1801VM3/1801VM3-Board/Eagle/1203_054.brd

## EAGLE design Eagle/1203_054.brd (2017-02-23)

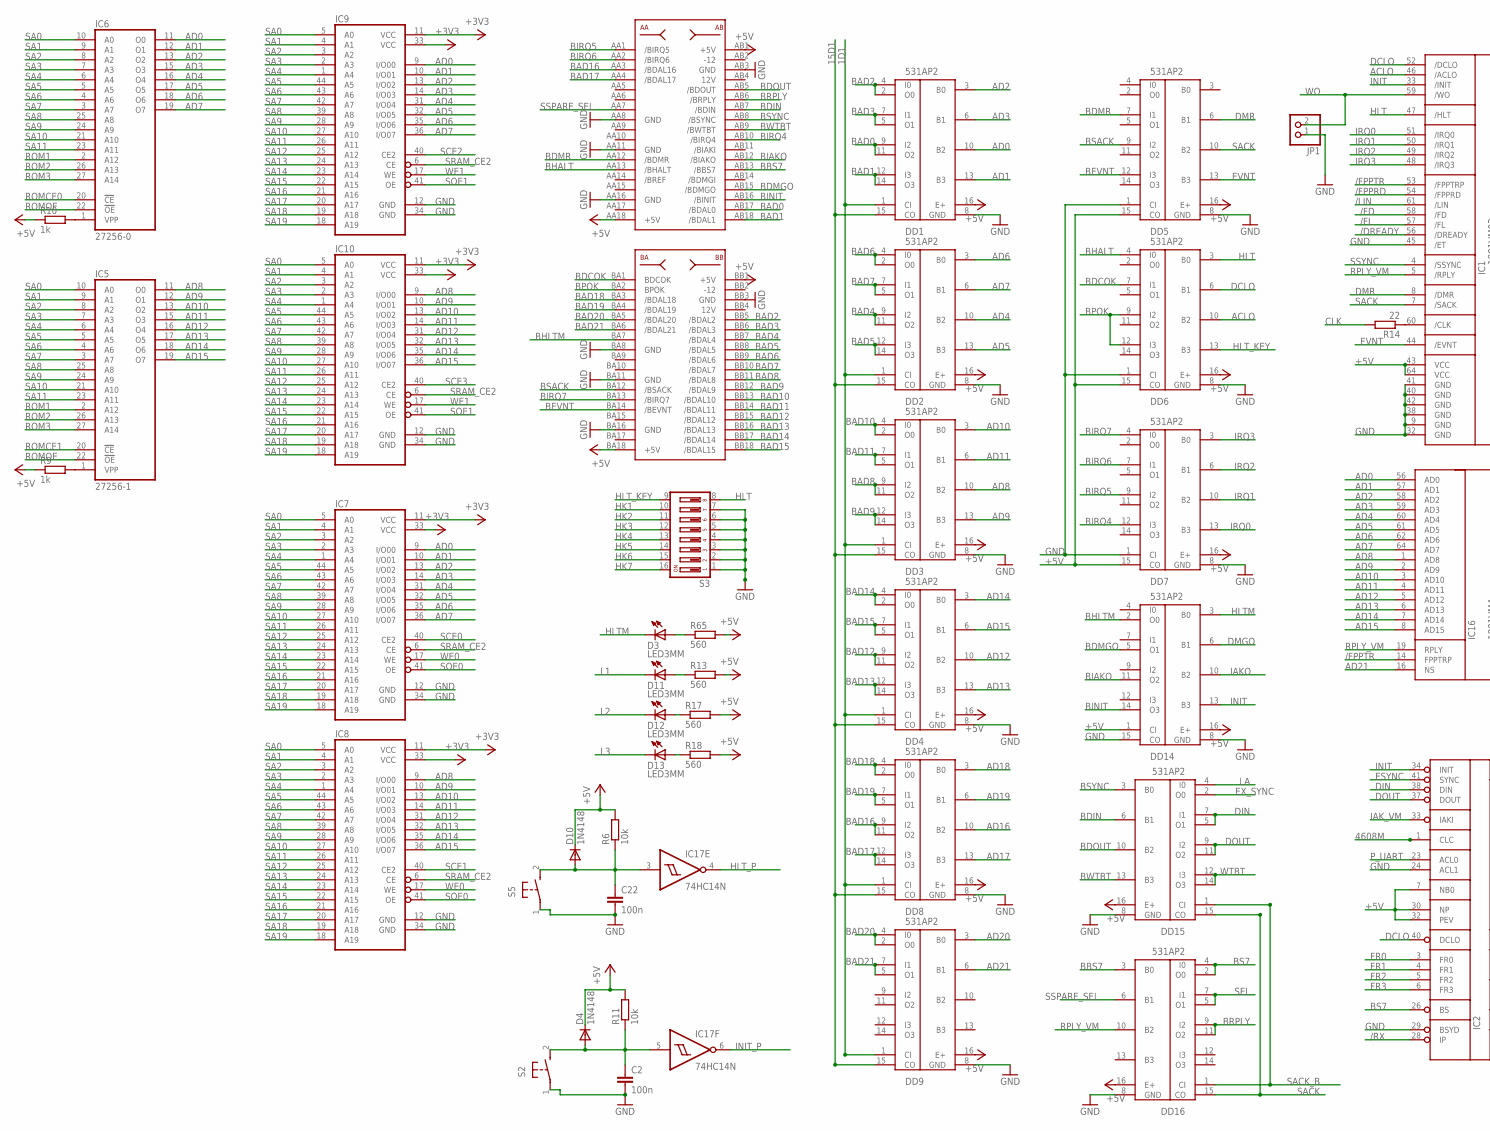
[picture p1: schematic 1203_054.sch, sheet 1, part in row 1, column 1]

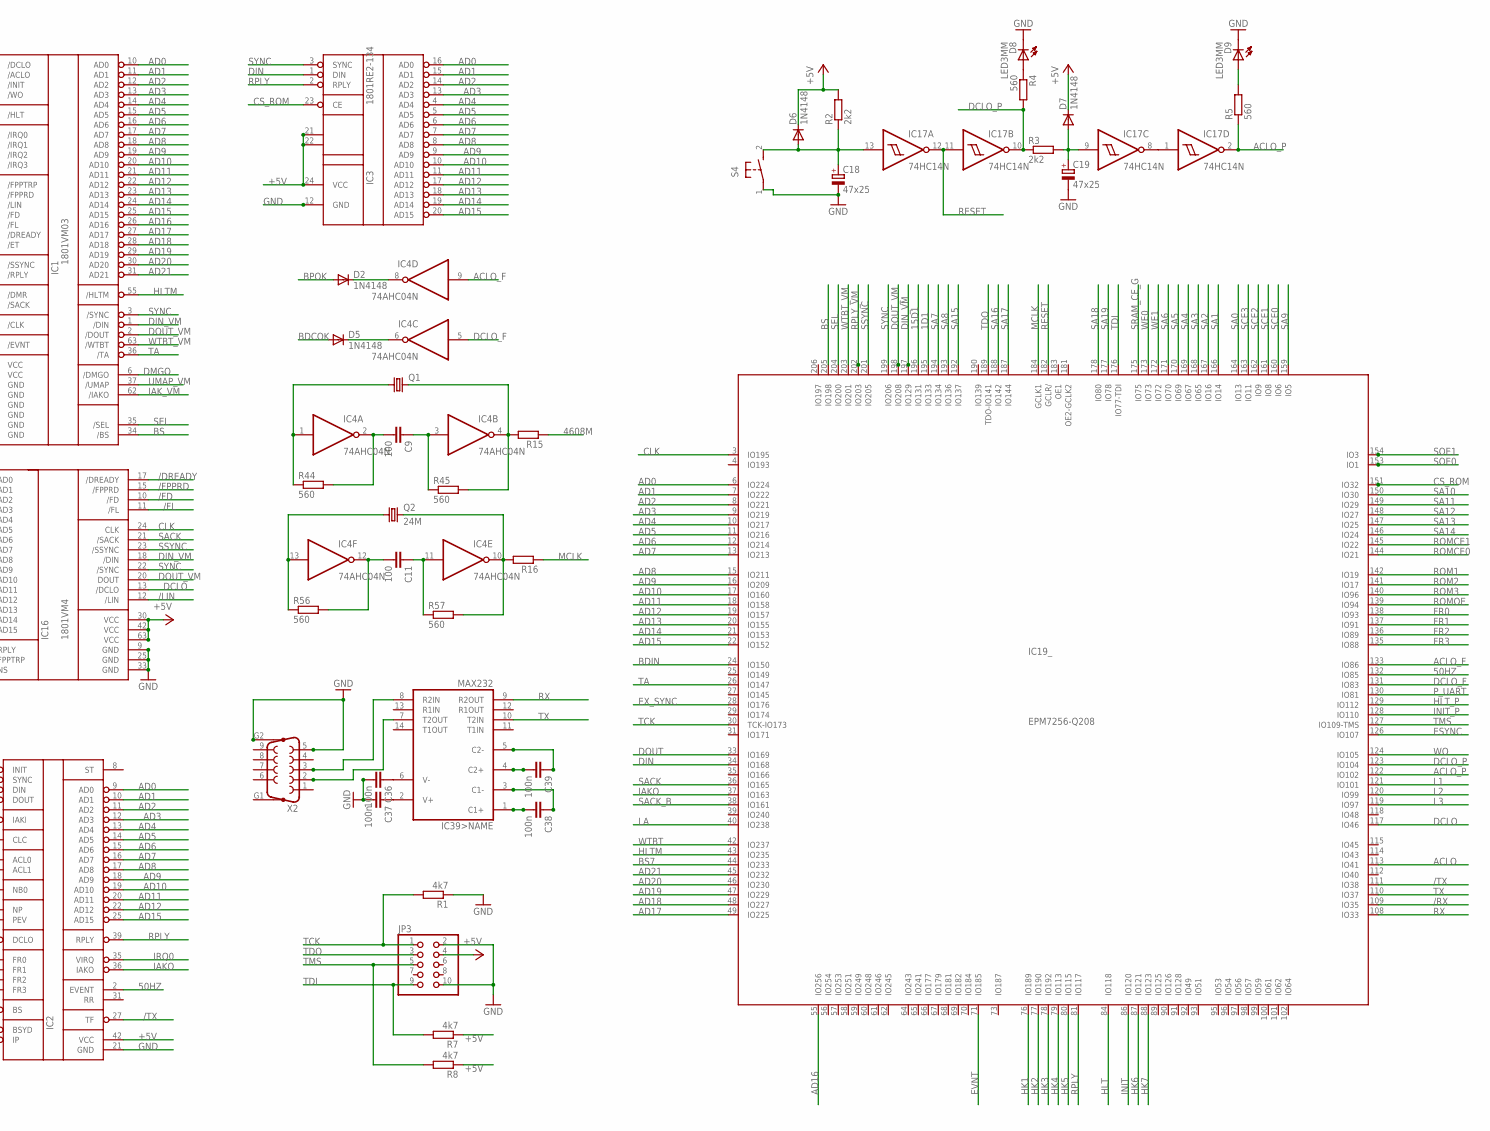
[picture p2: schematic 1203_054.sch, sheet 1, part in row 1, column 2]

Parts:
C2, C22: 100n; C050-024X044
C9, C11: 100; C025-024X044
C18, C19: 47x25; E2,5-5
C36, C37, C38, C39: 100n; C025-024X044
D2, D4, D5, D6, D7, D10: 1N4148; DO35-10
D3, D8, D9, D11, D12, D13: LED3MM
DD1, DD2, DD3, DD4, DD5, DD6, DD7, DD8, DD9, DD14, DD15, DD16: 531AP2; DIL16
IC1: 1801VM03; DIL64
IC2: 1801VP1-065; 1801
IC3: 1801RE2-134; DIL24
IC4: 74AHC04N; DIL14
IC5: 27256-1; DIL28
IC6: 27256-0; DIL28
IC7, IC8, IC9, IC10: AS6C800855Z; TSOP44
IC16: 1801VM4
IC17: 74HC14N; DIL14
IC19: EPM7256-Q208; RQFP208
IC39: MAX232; DIL16
JP1: PINHD-1X2; 1X02
JP3: PINHD-2X5; 2X05
Q1: HC49U70
Q2: 24M; HC49U70
R1, R7, R8: 4k7; M0805
R2, R3: 2k2; 0207/10
R4, R5, R13, R17, R18, R65: 560; M0805
R6, R11: 10k; 0207/10
R9, R10: 1k; M0805
R14: 22; 0204V
R15, R16: R-EU_0204/2V; 0204V
R44, R45, R56, R57: 560; 0204V
S2, S4, S5: 31-XX; B3F-31XX
S3: DP08; DP-08
X2: F09HP
XP1: CON1

Connections:
1D1: DD1.1 (CI), DD2.1 (CI), DD3.1 (CI), DD4.1 (CI), DD8.1 (CI), DD9.1 (CI), IC19.195 (IO133); also elsewhere on the board
15D1: DD1.15 (CO), DD2.15 (CO), DD3.15 (CO), DD4.15 (CO), DD8.15 (CO), DD9.15 (CO), IC19.196 (IO131)
50HZ: IC2.2 (EVENT), IC19.132 (IO85)
4608M: IC2.1 (CLC), R15.1
4608MM: IC4.10 (O), Q2.2, R16.2, R57.2
+3V3: IC7.11 (VCC), IC7.33 (VCC), IC8.11 (VCC), IC8.33 (VCC), IC9.11 (VCC), IC9.33 (VCC), IC10.11 (VCC), IC10.33 (VCC); also elsewhere on the board
+5V: D4.K (C), D6.K (C), D7.K (C), D10.K (C), DD1.16 (E+), DD2.16 (E+), DD3.16 (E+), DD4.16 (E+), DD5.15 (CO), DD5.16 (E+), DD6.15 (CO), DD6.16 (E+), DD7.15 (CO), DD7.16 (E+), DD8.16 (E+), DD9.16 (E+), DD14.1 (CI), DD14.16 (E+), DD15.16 (E+), DD16.16 (E+), IC1.43 (VCC), IC1.64 (VCC), IC2.7 (NB0), IC2.30 (NP), IC2.32 (PEV), IC2.42 (VCC), IC3.21 (F0), IC3.22 (F1), IC3.24 (VCC), IC4.14 (VCC), IC5.28 (VCC), IC6.28 (VCC), IC16.30 (VCC), IC16.42 (VCC), IC16.63 (VCC), IC17.14 (VCC), IC19.83 (VCC), IC19.179 (VCC), IC19.186 (VCC), JP3.4, R2.2, R6.2, R7.1, R8.1, R9.1, R10.1, R11.2, R13.2, R17.2, R18.2, R65.2, XP1.AA18 (+5V), XP1.AB1 (+5V), XP1.BA18 (+5V), XP1.BB1 (+5V); also elsewhere on the board
/DREADY: IC1.56 (/DREADY), IC16.17 (/DREADY); also elsewhere on the board
/FD: IC1.58 (/FD), IC16.10 (/FD); also elsewhere on the board
/FL: IC1.57 (/FL), IC16.11 (/FL); also elsewhere on the board
/FPPRD: IC1.54 (/FPPRD), IC16.15 (/FPPRD); also elsewhere on the board
/FPPTR: IC1.53 (/FPPTRP), IC16.14 (FPPTRP); also elsewhere on the board
/LIN: IC1.61 (/LIN), IC16.12 (/LIN); also elsewhere on the board
/RX: IC2.28 (IP), IC19.109 (IO35)
/TX: IC2.27 (TF), IC19.111 (IO38)
ACLO: DD6.10 (B2), IC1.46 (/ACLO), IC19.113 (IO41); also elsewhere on the board
ACLO_F: IC4.9 (I), IC19.133 (IO86)
ACLO_P: IC17.2 (O), IC19.122 (IO102), R5.1
AD0: DD1.10 (B2), IC1.10 (AD0), IC2.9 (AD0), IC3.16 (AD0), IC6.11 (O0), IC7.9 (I/O00), IC9.9 (I/O00), IC16.56 (AD0), IC19.6 (IO224); also elsewhere on the board
AD1: DD1.13 (B3), IC1.11 (AD1), IC2.10 (AD1), IC3.15 (AD1), IC6.12 (O1), IC7.10 (I/O01), IC9.10 (I/O01), IC16.57 (AD1), IC19.7 (IO222); also elsewhere on the board
AD2: DD1.3 (B0), IC1.12 (AD2), IC2.11 (AD2), IC3.14 (AD2), IC6.13 (O2), IC7.13 (I/O02), IC9.13 (I/O02), IC16.58 (AD2), IC19.8 (IO221); also elsewhere on the board
AD3: DD1.6 (B1), IC1.13 (AD3), IC2.12 (AD3), IC3.13 (AD3), IC6.15 (O3), IC7.14 (I/O03), IC9.14 (I/O03), IC16.59 (AD3), IC19.9 (IO219); also elsewhere on the board
AD4: DD2.10 (B2), IC1.14 (AD4), IC2.13 (AD4), IC3.4 (AD4), IC6.16 (O4), IC7.31 (I/O04), IC9.31 (I/O04), IC16.60 (AD4), IC19.10 (IO217); also elsewhere on the board
AD5: DD2.13 (B3), IC1.15 (AD5), IC2.14 (AD5), IC3.5 (AD5), IC6.17 (O5), IC7.32 (I/O05), IC9.32 (I/O05), IC16.61 (AD5), IC19.11 (IO216); also elsewhere on the board
AD6: DD2.3 (B0), IC1.16 (AD6), IC2.15 (AD6), IC3.6 (AD6), IC6.18 (O6), IC7.35 (I/O06), IC9.35 (I/O06), IC16.62 (AD6), IC19.12 (IO214); also elsewhere on the board
AD7: DD2.6 (B1), IC1.17 (AD7), IC2.16 (AD7), IC3.7 (AD7), IC6.19 (O7), IC7.36 (I/O07), IC9.36 (I/O07), IC16.64 (AD7), IC19.13 (IO213); also elsewhere on the board
AD8: DD3.10 (B2), IC1.18 (AD8), IC2.17 (AD8), IC3.8 (AD8), IC5.11 (O0), IC8.9 (I/O00), IC10.9 (I/O00), IC16.1 (AD8), IC19.15 (IO211); also elsewhere on the board
AD9: DD3.13 (B3), IC1.19 (AD9), IC2.18 (AD9), IC3.9 (AD9), IC5.12 (O1), IC8.10 (I/O01), IC10.10 (I/O01), IC16.2 (AD9), IC19.16 (IO209); also elsewhere on the board
AD10: DD3.3 (B0), IC1.20 (AD10), IC2.19 (AD10), IC3.10 (AD10), IC5.13 (O2), IC8.13 (I/O02), IC10.13 (I/O02), IC16.3 (AD10), IC19.17 (IO160); also elsewhere on the board
AD11: DD3.6 (B1), IC1.21 (AD11), IC2.20 (AD11), IC3.11 (AD11), IC5.15 (O3), IC8.14 (I/O03), IC10.14 (I/O03), IC16.4 (AD11), IC19.18 (IO158); also elsewhere on the board
AD12: DD4.10 (B2), IC1.22 (AD12), IC2.22 (AD12), IC3.17 (AD12), IC5.16 (O4), IC8.31 (I/O04), IC10.31 (I/O04), IC16.5 (AD12), IC19.19 (IO157); also elsewhere on the board
AD13: DD4.13 (B3), IC1.23 (AD13), IC3.18 (AD13), IC5.17 (O5), IC8.32 (I/O05), IC10.32 (I/O05), IC16.6 (AD13), IC19.20 (IO155); also elsewhere on the board
AD14: DD4.3 (B0), IC1.24 (AD14), IC3.19 (AD14), IC5.18 (O6), IC8.35 (I/O06), IC10.35 (I/O06), IC16.7 (AD14), IC19.21 (IO153); also elsewhere on the board
AD15: DD4.6 (B1), IC1.25 (AD15), IC2.25 (AD15), IC3.20 (AD15), IC5.19 (O7), IC8.36 (I/O07), IC10.36 (I/O07), IC16.8 (AD15), IC19.22 (IO152); also elsewhere on the board
AD16: DD8.10 (B2), IC1.26 (AD16), IC19.55 (IO256); also elsewhere on the board
AD17: DD8.13 (B3), IC1.27 (AD17), IC19.49 (IO225); also elsewhere on the board
AD18: DD8.3 (B0), IC1.28 (AD18), IC19.48 (IO227); also elsewhere on the board
AD19: DD8.6 (B1), IC1.29 (AD19), IC19.47 (IO229); also elsewhere on the board
AD20: DD9.3 (B0), IC1.30 (AD20), IC19.46 (IO230); also elsewhere on the board
AD21: DD9.6 (B1), IC1.31 (AD21), IC16.16 (NS), IC19.45 (IO232); also elsewhere on the board
BAD0: DD1.9 (I2), DD1.11 (O2), XP1.AB17 (/BDAL0); also elsewhere on the board
BAD1: DD1.12 (I3), DD1.14 (O3), XP1.AB18 (/BDAL1); also elsewhere on the board
BAD2: DD1.2 (O0), DD1.4 (I0), XP1.BB5 (/BDAL2); also elsewhere on the board
BAD3: DD1.5 (O1), DD1.7 (I1), XP1.BB6 (/BDAL3); also elsewhere on the board
BAD4: DD2.9 (I2), DD2.11 (O2), XP1.BB7 (/BDAL4); also elsewhere on the board
BAD5: DD2.12 (I3), DD2.14 (O3), XP1.BB8 (/BDAL5); also elsewhere on the board
BAD6: DD2.2 (O0), DD2.4 (I0), XP1.BB9 (/BDAL6); also elsewhere on the board
BAD7: DD2.5 (O1), DD2.7 (I1), XP1.BB10 (/BDAL7); also elsewhere on the board
BAD8: DD3.9 (I2), DD3.11 (O2), XP1.BB11 (/BDAL8); also elsewhere on the board
BAD9: DD3.12 (I3), DD3.14 (O3), XP1.BB12 (/BDAL9); also elsewhere on the board
BAD10: DD3.2 (O0), DD3.4 (I0), XP1.BB13 (/BDAL10); also elsewhere on the board
BAD11: DD3.5 (O1), DD3.7 (I1), XP1.BB14 (/BDAL11); also elsewhere on the board
BAD12: DD4.9 (I2), DD4.11 (O2), XP1.BB15 (/BDAL12); also elsewhere on the board
BAD13: DD4.12 (I3), DD4.14 (O3), XP1.BB16 (/BDAL13); also elsewhere on the board
BAD14: DD4.2 (O0), DD4.4 (I0), XP1.BB17 (/BDAL14); also elsewhere on the board
BAD15: DD4.5 (O1), DD4.7 (I1), XP1.BB18 (/BDAL15); also elsewhere on the board
BAD16: DD8.9 (I2), DD8.11 (O2), XP1.AA3 (/BDAL16); also elsewhere on the board
BAD17: DD8.12 (I3), DD8.14 (O3), XP1.AA4 (/BDAL17); also elsewhere on the board
BAD18: DD8.2 (O0), DD8.4 (I0), XP1.BA3 (/BDAL18); also elsewhere on the board
BAD19: DD8.5 (O1), DD8.7 (I1), XP1.BA4 (/BDAL19); also elsewhere on the board
BAD20: DD9.2 (O0), DD9.4 (I0), XP1.BA5 (/BDAL20); also elsewhere on the board
BAD21: DD9.5 (O1), DD9.7 (I1), XP1.BA6 (/BDAL21); also elsewhere on the board
BBS7: DD16.3 (B0), XP1.AB13 (/BBS7); also elsewhere on the board
BDCOK: D5.A, DD6.7 (I1), XP1.BA1 (BDCOK); also elsewhere on the board
BDIN: DD15.6 (B1), IC19.24 (IO150), XP1.AB7 (/BDIN); also elsewhere on the board
BDMGO: DD14.5 (O1), XP1.AB15 (/BDMGO); also elsewhere on the board
BDMR: DD5.7 (I1), XP1.AA12 (/BDMR); also elsewhere on the board
BDOUT: DD15.10 (B2), XP1.AB5 (/BDOUT); also elsewhere on the board
BEVNT: DD5.12 (I3), XP1.BA14 (/BEVNT); also elsewhere on the board
BHALT: DD6.4 (I0), XP1.AA13 (/BHALT); also elsewhere on the board
BHLTM: DD14.2 (O0), XP1.BA7; also elsewhere on the board
BIAKO: DD14.11 (O2), XP1.AB12 (/BIAKO); also elsewhere on the board
BINIT: DD14.14 (O3), XP1.AB16 (/BINIT); also elsewhere on the board
BIRQ4: DD7.12 (I3), XP1.AB10 (/BIRQ4); also elsewhere on the board
BIRQ5: DD7.9 (I2), XP1.AA1 (/BIRQ5); also elsewhere on the board
BIRQ6: DD7.7 (I1), XP1.AA2 (/BIRQ6); also elsewhere on the board
BIRQ7: DD7.4 (I0), XP1.BA13 (/BIRQ7); also elsewhere on the board
BPOK: D2.A, DD6.9 (I2), DD6.12 (I3), XP1.BA2 (BPOK); also elsewhere on the board
BRPLY: DD16.9 (I2), DD16.11 (O2), XP1.AB6 (/BRPLY); also elsewhere on the board
BS: IC1.34 (/BS), IC19.205 (IO198); also elsewhere on the board
BS7: DD16.2 (O0), DD16.4 (I0), IC2.26 (BS), IC19.44 (IO233); also elsewhere on the board
BSACK: DD5.9 (I2), XP1.BA12 (/BSACK); also elsewhere on the board
BSYNC: DD15.3 (B0), XP1.AB8 (/BSYNC); also elsewhere on the board
BWTBT: DD15.13 (B3), XP1.AB9 (/BWTBT); also elsewhere on the board
CLK: IC16.24 (CLK), IC19.3 (IO195), R14.2
CS_ROM: IC3.23 (CE), IC19.151 (IO32)
DCLO: DD6.6 (B1), IC1.52 (/DCLO), IC2.40 (DCLO), IC16.13 (/DCLO), IC19.117 (IO46); also elsewhere on the board
DCLO_F: IC4.5 (I), IC19.131 (IO83)
DCLO_P: IC17.10 (O), IC19.123 (IO104), R3.1, R4.2
DIN: DD15.5 (O1), DD15.7 (I1), IC2.38 (DIN), IC3.1 (DIN), IC19.34 (IO168); also elsewhere on the board
DIN_VM: IC1.1 (/DIN), IC16.18 (/DIN), IC19.197 (IO129); also elsewhere on the board
DMGO: DD14.6 (B1), IC1.6 (/DMGO); also elsewhere on the board
DMR: DD5.6 (B1), IC1.8 (/DMR); also elsewhere on the board
DOUT: DD15.9 (I2), DD15.11 (O2), IC2.37 (DOUT), IC19.33 (IO169); also elsewhere on the board
DOUT_VM: IC1.2 (/DOUT), IC16.20 (DOUT), IC19.198 (IO208); also elsewhere on the board
ESYNC: IC2.41 (SYNC), IC19.126 (IO107)
EVNT: DD5.13 (B3), IC1.44 (/EVNT), IC19.71 (IO185); also elsewhere on the board
EX_SYNC: DD15.2 (O0), IC19.28 (IO176); also elsewhere on the board
FR0: IC2.3 (FR0), IC19.138 (IO93)
FR1: IC2.4 (FR1), IC19.137 (IO91)
FR2: IC2.5 (FR2), IC19.136 (IO89)
FR3: IC2.6 (FR3), IC19.135 (IO88)
GND: C2.2, C18.-, C19.-, C22.2, C36.2, C37.2, D8.K (C), D9.K (C), DD1.8 (GND), DD2.8 (GND), DD3.8 (GND), DD4.8 (GND), DD5.1 (CI), DD5.8 (GND), DD6.1 (CI), DD6.8 (GND), DD7.1 (CI), DD7.8 (GND), DD8.8 (GND), DD9.8 (GND), DD14.8 (GND), DD14.15 (CO), DD15.8 (GND), DD16.8 (GND), IC1.9 (GND), IC1.32 (GND), IC1.38 (GND), IC1.40 (GND), IC1.41 (GND), IC1.42 (GND), IC1.45 (/ET), IC2.21 (GND), IC2.24 (ACL1), IC2.29 (BSYD), IC3.12 (GND), IC4.7 (GND), IC5.14 (GND), IC6.14 (GND), IC7.12 (GND), IC7.34 (GND), IC8.12 (GND), IC8.34 (GND), IC9.12 (GND), IC9.34 (GND), IC10.12 (GND), IC10.34 (GND), IC16.9 (GND), IC16.25 (GND), IC16.33 (GND), IC17.7 (GND), JP1.1, JP3.2, JP3.10, R1.1, S2.1, S3.1, S3.2, S3.3, S3.4, S3.5, S3.6, S3.7, S4.1, S5.1, X2.5, X2.G2, XP1.AA8 (GND), XP1.AA11 (GND), XP1.AA16 (GND), XP1.AB3 (GND), XP1.BA8 (GND), XP1.BA11 (GND), XP1.BA16 (GND), XP1.BB3 (GND); also elsewhere on the board
HK1: IC19.76 (IO189), S3.10; also elsewhere on the board
HK2: IC19.77 (IO190), S3.11; also elsewhere on the board
HK3: IC19.78 (IO192), S3.12; also elsewhere on the board
HK4: IC19.79 (IO113), S3.13; also elsewhere on the board
HK5: IC19.80 (IO115), S3.14; also elsewhere on the board
HK6: IC19.87 (IO121), S3.15; also elsewhere on the board
HK7: IC19.88 (IO123), S3.16; also elsewhere on the board
HLT: DD6.3 (B0), IC1.47 (/HLT), IC19.84 (IO118), S3.8; also elsewhere on the board
HLTM: D3.K (C), DD14.3 (B0), IC1.55 (/HLTM), IC19.43 (IO235); also elsewhere on the board
HLT_KEY: DD6.13 (B3), S3.9
HLT_P: IC17.4 (O), IC19.129 (IO112)
IAKO: DD14.10 (B2), IC2.36 (IAKO), IC19.37 (IO163)
IAK_VM: IC1.62 (/IAKO), IC2.33 (IAKI); also elsewhere on the board
INIT: DD14.13 (B3), IC1.33 (/INIT), IC2.34 (INIT), IC19.86 (IO120); also elsewhere on the board
INIT_P: IC17.6 (O), IC19.128 (IO110)
IRQ0: DD7.13 (B3), IC1.51 (/IRQ0), IC2.35 (VIRQ); also elsewhere on the board
IRQ1: DD7.10 (B2), IC1.50 (/IRQ1); also elsewhere on the board
IRQ2: DD7.6 (B1), IC1.49 (/IRQ2); also elsewhere on the board
IRQ3: DD7.3 (B0), IC1.48 (/IRQ3); also elsewhere on the board
L1: D11.K (C), IC19.121 (IO101)
L2: D12.K (C), IC19.120 (IO99)
L3: D13.K (C), IC19.119 (IO97)
LA: DD15.4 (I0), IC19.40 (IO238)
MCLK: IC19.184 (GCLK1), R16.1
MCLKK: IC4.4 (O), Q1.2, R15.2, R45.2
unnamed: IC6.1 (VPP), R10.2
unnamed: IC17.1 (I), IC17.8 (O)
unnamed: C38.1, IC39.3 (C1-)
unnamed: D9.A, R5.2
unnamed: C18.+, D6.A, IC17.13 (I), R2.1, S4.2
unnamed: IC4.1 (I), Q1.1, R44.1
unnamed: D3.A, R65.1
unnamed: C9.2, IC4.2 (O), R44.2
unnamed: C19.+, D7.A, IC17.9 (I), R3.2
unnamed: D8.A, R4.1
unnamed: IC5.1 (VPP), R9.2
unnamed: C22.1, D10.A, IC17.3 (I), R6.1, S5.2
unnamed: D11.A, R13.1
unnamed: IC1.60 (/CLK), R14.1
unnamed: D2.K (C), IC4.8 (O)
unnamed: D5.K (C), IC4.6 (O)
unnamed: C2.1, D4.A, IC17.5 (I), R11.1, S2.2
unnamed: D12.A, R17.1
unnamed: D13.A, R18.1
unnamed: IC4.13 (I), Q2.1, R56.1
unnamed: C9.1, IC4.3 (I), R45.1
unnamed: C38.2, IC39.1 (C1+)
unnamed: C39.2, IC39.4 (C2+)
unnamed: C39.1, IC39.5 (C2-)
unnamed: IC39.7 (T2OUT), X2.2
unnamed: IC39.8 (R2IN), X2.3
unnamed: C36.1, IC39.6 (V-)
unnamed: C37.1, IC39.2 (V+)
unnamed: C11.2, IC4.12 (O), R56.2
unnamed: C11.1, IC4.11 (I), R57.1
P_UART: IC2.23 (ACL0), IC19.130 (IO81)
RESET: IC17.11 (I), IC17.12 (O), IC19.182 (GCLR/)
ROM1: IC5.2 (A12), IC6.2 (A12), IC19.142 (IO19)
ROM2: IC5.26 (A13), IC6.26 (A13), IC19.141 (IO17)
ROM3: IC5.27 (A14), IC6.27 (A14), IC19.140 (IO96)
ROMCE0: IC6.20 (!CE), IC19.144 (IO21)
ROMCE1: IC5.20 (!CE), IC19.145 (IO22)
ROMOE: IC5.22 (!OE), IC6.22 (!OE), IC19.139 (IO94)
RPLY: IC2.39 (RPLY), IC3.2 (RPLY), IC19.81 (IO117); also elsewhere on the board
RPLY_VM: DD16.10 (B2), IC1.5 (/RPLY), IC16.19 (RPLY), IC19.202 (IO203); also elsewhere on the board
RX: IC19.108 (IO33), IC39.9 (R2OUT)
SA0: IC5.10 (A0), IC6.10 (A0), IC7.5 (A0), IC8.5 (A0), IC9.5 (A0), IC10.5 (A0), IC19.164 (IO13)
SA1: IC5.9 (A1), IC6.9 (A1), IC7.4 (A1), IC8.4 (A1), IC9.4 (A1), IC10.4 (A1), IC19.166 (IO14)
SA2: IC5.8 (A2), IC6.8 (A2), IC7.3 (A2), IC8.3 (A2), IC9.3 (A2), IC10.3 (A2), IC19.167 (IO16)
SA3: IC5.7 (A3), IC6.7 (A3), IC7.2 (A3), IC8.2 (A3), IC9.2 (A3), IC10.2 (A3), IC19.168 (IO65)
SA4: IC5.6 (A4), IC6.6 (A4), IC7.1 (A4), IC8.1 (A4), IC9.1 (A4), IC10.1 (A4), IC19.169 (IO67)
SA5: IC5.5 (A5), IC6.5 (A5), IC7.44 (A5), IC8.44 (A5), IC9.44 (A5), IC10.44 (A5), IC19.170 (IO69)
SA6: IC5.4 (A6), IC6.4 (A6), IC7.43 (A6), IC8.43 (A6), IC9.43 (A6), IC10.43 (A6), IC19.171 (IO70)
SA7: IC5.3 (A7), IC6.3 (A7), IC7.42 (A7), IC8.42 (A7), IC9.42 (A7), IC10.42 (A7), IC19.194 (IO134)
SA8: IC5.25 (A8), IC6.25 (A8), IC7.39 (A8), IC8.39 (A8), IC9.39 (A8), IC10.39 (A8), IC19.193 (IO136)
SA9: IC5.24 (A9), IC6.24 (A9), IC7.28 (A9), IC8.28 (A9), IC9.28 (A9), IC10.28 (A9), IC19.159 (IO5)
SA10: IC5.21 (A10), IC6.21 (A10), IC7.27 (A10), IC8.27 (A10), IC9.27 (A10), IC10.27 (A10), IC19.150 (IO30)
SA11: IC5.23 (A11), IC6.23 (A11), IC7.26 (A11), IC8.26 (A11), IC9.26 (A11), IC10.26 (A11), IC19.149 (IO29)
SA12: IC7.25 (A12), IC8.25 (A12), IC9.25 (A12), IC10.25 (A12), IC19.148 (IO27)
SA13: IC7.24 (A13), IC8.24 (A13), IC9.24 (A13), IC10.24 (A13), IC19.147 (IO25)
SA14: IC7.23 (A14), IC8.23 (A14), IC9.23 (A14), IC10.23 (A14), IC19.146 (IO24)
SA15: IC7.22 (A15), IC8.22 (A15), IC9.22 (A15), IC10.22 (A15), IC19.192 (IO137)
SA16: IC7.21 (A16), IC8.21 (A16), IC9.21 (A16), IC10.21 (A16), IC19.188 (IO142)
SA17: IC7.20 (A17), IC8.20 (A17), IC9.20 (A17), IC10.20 (A17), IC19.187 (IO144)
SA18: IC7.19 (A18), IC8.19 (A18), IC9.19 (A18), IC10.19 (A18), IC19.178 (IO80)
SA19: IC7.18 (A19), IC8.18 (A19), IC9.18 (A19), IC10.18 (A19), IC19.177 (IO78)
SACK: DD5.10 (B2), DD15.15 (CO), DD16.15 (CO), IC1.7 (/SACK), IC16.21 (/SACK), IC19.36 (IO165); also elsewhere on the board
SACK_B: DD15.1 (CI), DD16.1 (CI), IC19.38 (IO161)
SCE0: IC7.40 (CE2), IC19.160 (IO6)
SCE1: IC8.40 (CE2), IC19.161 (IO8)
SCE2: IC9.40 (CE2), IC19.162 (IO9)
SCE3: IC10.40 (CE2), IC19.163 (IO11)
SEL: DD16.5 (O1), DD16.7 (I1), IC1.35 (/SEL), IC19.204 (IO200); also elsewhere on the board
SOE0: IC7.41 (OE), IC8.41 (OE), IC19.153 (IO1)
SOE1: IC9.41 (OE), IC10.41 (OE), IC19.154 (IO3)
SRAM_CE2: IC7.6 (CE), IC8.6 (CE), IC9.6 (CE), IC10.6 (CE); also elsewhere on the board
SRAM_CE_G: IC19.175 (IO75); also elsewhere on the board
SSPARE_SEL: DD16.6 (B1), XP1.AA7; also elsewhere on the board
SSYNC: IC1.4 (/SSYNC), IC16.23 (/SSYNC), IC19.201 (IO205); also elsewhere on the board
SYNC: IC1.3 (/SYNC), IC3.3 (SYNC), IC16.22 (/SYNC), IC19.199 (IO206); also elsewhere on the board
TA: IC1.36 (/TA), IC19.26 (IO147); also elsewhere on the board
TCK: IC19.30 (TCK-IO173), JP3.1, R1.2
TDI: IC19.176 (IO77-TDI), JP3.9, R7.2
TDO: IC19.189 (TDO-IO141), JP3.3
TMS: IC19.127 (IO109-TMS), JP3.5, R8.2
TX: IC19.110 (IO37), IC39.10 (T2IN)
UMAP_VM: IC1.37 (/UMAP); also elsewhere on the board
WE0: IC7.17 (WE), IC8.17 (WE), IC19.173 (IO73)
WE1: IC9.17 (WE), IC10.17 (WE), IC19.172 (IO72)
WO: IC1.59 (/WO), IC19.124 (IO105), JP1.2; also elsewhere on the board
WTBT: DD15.12 (I3), DD15.14 (O3), IC19.42 (IO237); also elsewhere on the board
WTBT_VM: IC1.63 (/WTBT), IC19.203 (IO201); also elsewhere on the board

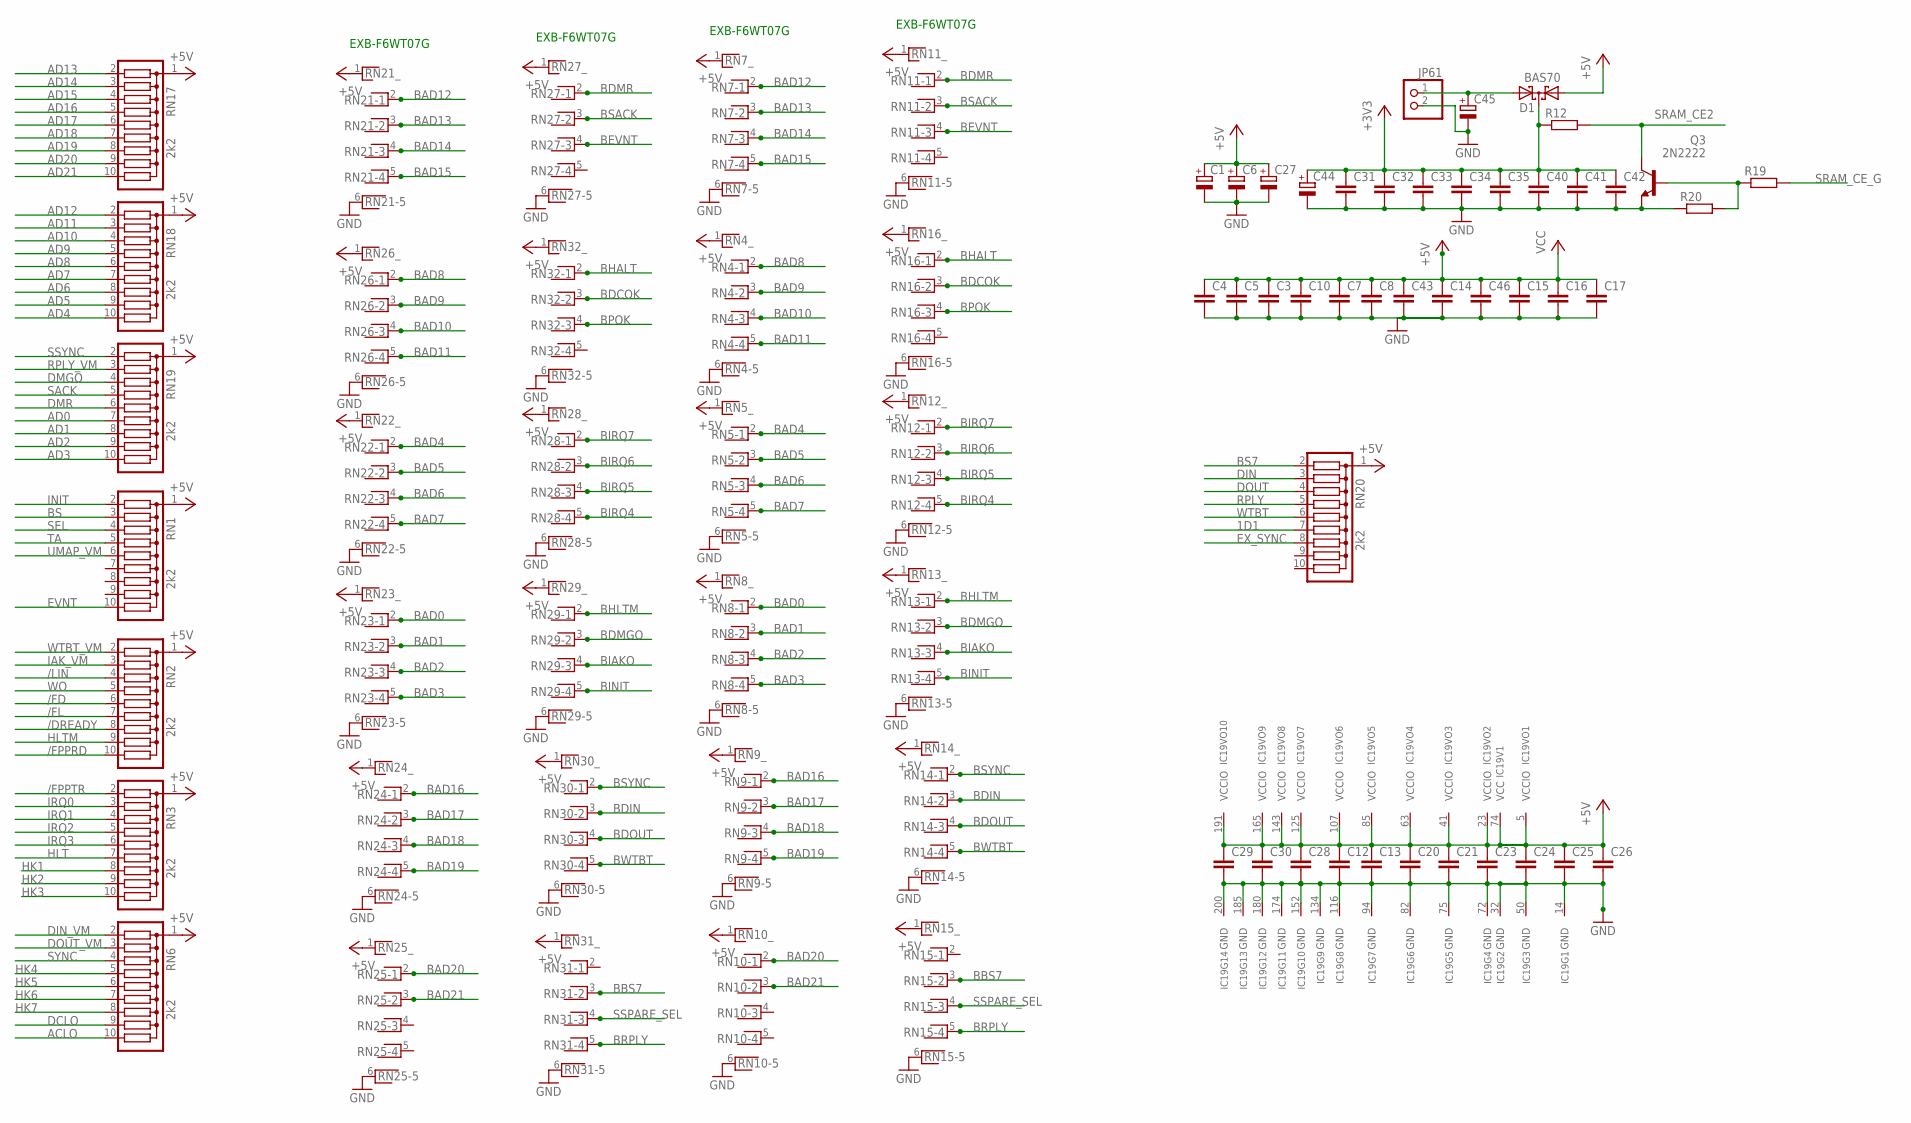
[picture p3: schematic 1203_054.sch, sheet 2]

Parts:
C1, C6, C27: CPOL-EUCT6032; CT6032
C3, C4, C5, C7, C8, C10, C14, C15, C16, C17, C23, C24, C25, C26, C28, C29, C30, C43, C46: C-EU050-024X044; C050-024X044
C12, C13, C20, C21: C-EUC0805; C0805
C31, C32, C33, C34, C35, C40, C41, C42: C-EUC0603; C0603
C44, C45: CPOL-EUCT7343; CT7343
D1: BAS70; SOT23
IC19: EPM7256-Q208; RQFP208
JP61: PINHD-1X2; 1X02
Q3: 2N2222; TO18
R12, R19, R20: R-EU_M0805; M0805
RN1, RN2, RN3, RN6, RN17, RN18, RN19, RN20: 2k2; SIL10
RN4, RN5, RN7, RN8, RN9, RN10, RN11, RN12, RN13, RN14, RN15, RN16, RN21, RN22, RN23, RN24, RN25, RN26, RN27, RN28, RN29, RN30, RN31, RN32: RNX5; RN-6

Connections:
1D1: RN20.7; also elsewhere on the board
+3V3: C31.1, C32.1, C33.1, C34.1, C35.1, C40.1, C41.1, C42.1, C44.+, D1.3 (C), R12.1; also elsewhere on the board
+5V: C1.+, C3.1, C4.1, C5.1, C6.+, C7.1, C8.1, C10.1, C12.1, C13.1, C14.1, C15.1, C16.1, C17.1, C20.1, C21.1, C23.1, C24.1, C25.1, C26.1, C27.+, C28.1, C29.1, C30.1, C43.1, C46.1, D1.1 (A1), IC19.5 (VCCIO), IC19.23 (VCCIO), IC19.41 (VCCIO), IC19.63 (VCCIO), IC19.74 (VCC), IC19.83 (VCC), IC19.85 (VCCIO), IC19.107 (VCCIO), IC19.125 (VCCIO), IC19.143 (VCCIO), IC19.165 (VCCIO), IC19.179 (VCC), IC19.186 (VCC), IC19.191 (VCCIO), RN1.1, RN2.1, RN3.1, RN4.1, RN5.1, RN6.1, RN7.1, RN8.1, RN9.1, RN10.1, RN11.1, RN12.1, RN13.1, RN14.1, RN15.1, RN16.1, RN17.1, RN18.1, RN19.1, RN20.1, RN21.1, RN22.1, RN23.1, RN24.1, RN25.1, RN26.1, RN27.1, RN28.1, RN29.1, RN30.1, RN31.1, RN32.1; also elsewhere on the board
/DREADY: RN2.8; also elsewhere on the board
/FD: RN2.6; also elsewhere on the board
/FL: RN2.7; also elsewhere on the board
/FPPRD: RN2.10; also elsewhere on the board
/FPPTR: RN3.2; also elsewhere on the board
/LIN: RN2.4; also elsewhere on the board
ACLO: RN6.10; also elsewhere on the board
AD0: RN19.7; also elsewhere on the board
AD1: RN19.8; also elsewhere on the board
AD2: RN19.9; also elsewhere on the board
AD3: RN19.10; also elsewhere on the board
AD4: RN18.10; also elsewhere on the board
AD5: RN18.9; also elsewhere on the board
AD6: RN18.8; also elsewhere on the board
AD7: RN18.7; also elsewhere on the board
AD8: RN18.6; also elsewhere on the board
AD9: RN18.5; also elsewhere on the board
AD10: RN18.4; also elsewhere on the board
AD11: RN18.3; also elsewhere on the board
AD12: RN18.2; also elsewhere on the board
AD13: RN17.2; also elsewhere on the board
AD14: RN17.3; also elsewhere on the board
AD15: RN17.4; also elsewhere on the board
AD16: RN17.5; also elsewhere on the board
AD17: RN17.6; also elsewhere on the board
AD18: RN17.7; also elsewhere on the board
AD19: RN17.8; also elsewhere on the board
AD20: RN17.9; also elsewhere on the board
AD21: RN17.10; also elsewhere on the board
BAD0: RN8.2, RN23.2; also elsewhere on the board
BAD1: RN8.3, RN23.3; also elsewhere on the board
BAD2: RN8.4, RN23.4; also elsewhere on the board
BAD3: RN8.5, RN23.5; also elsewhere on the board
BAD4: RN5.2, RN22.2; also elsewhere on the board
BAD5: RN5.3, RN22.3; also elsewhere on the board
BAD6: RN5.4, RN22.4; also elsewhere on the board
BAD7: RN5.5, RN22.5; also elsewhere on the board
BAD8: RN4.2, RN26.2; also elsewhere on the board
BAD9: RN4.3, RN26.3; also elsewhere on the board
BAD10: RN4.4, RN26.4; also elsewhere on the board
BAD11: RN4.5, RN26.5; also elsewhere on the board
BAD12: RN7.2, RN21.2; also elsewhere on the board
BAD13: RN7.3, RN21.3; also elsewhere on the board
BAD14: RN7.4, RN21.4; also elsewhere on the board
BAD15: RN7.5, RN21.5; also elsewhere on the board
BAD16: RN9.2, RN24.2; also elsewhere on the board
BAD17: RN9.3, RN24.3; also elsewhere on the board
BAD18: RN9.4, RN24.4; also elsewhere on the board
BAD19: RN9.5, RN24.5; also elsewhere on the board
BAD20: RN10.2, RN25.2; also elsewhere on the board
BAD21: RN10.3, RN25.3; also elsewhere on the board
BBS7: RN15.3, RN31.3; also elsewhere on the board
BDCOK: RN16.3, RN32.3; also elsewhere on the board
BDIN: RN14.3, RN30.3; also elsewhere on the board
BDMGO: RN13.3, RN29.3; also elsewhere on the board
BDMR: RN11.2, RN27.2; also elsewhere on the board
BDOUT: RN14.4, RN30.4; also elsewhere on the board
BEVNT: RN11.4, RN27.4; also elsewhere on the board
BHALT: RN16.2, RN32.2; also elsewhere on the board
BHLTM: RN13.2, RN29.2; also elsewhere on the board
BIAKO: RN13.4, RN29.4; also elsewhere on the board
BINIT: RN13.5, RN29.5; also elsewhere on the board
BIRQ4: RN12.5, RN28.5; also elsewhere on the board
BIRQ5: RN12.4, RN28.4; also elsewhere on the board
BIRQ6: RN12.3, RN28.3; also elsewhere on the board
BIRQ7: RN12.2, RN28.2; also elsewhere on the board
BPOK: RN16.4, RN32.4; also elsewhere on the board
BRPLY: RN15.5, RN31.5; also elsewhere on the board
BS: RN1.3; also elsewhere on the board
BS7: RN20.2; also elsewhere on the board
BSACK: RN11.3, RN27.3; also elsewhere on the board
BSYNC: RN14.2, RN30.2; also elsewhere on the board
BWTBT: RN14.5, RN30.5; also elsewhere on the board
DCLO: RN6.9; also elsewhere on the board
DIN: RN20.3; also elsewhere on the board
DIN_VM: RN6.2; also elsewhere on the board
DMGO: RN19.4; also elsewhere on the board
DMR: RN19.6; also elsewhere on the board
DOUT: RN20.4; also elsewhere on the board
DOUT_VM: RN6.3; also elsewhere on the board
EVNT: RN1.10; also elsewhere on the board
EX_SYNC: RN20.8; also elsewhere on the board
GND: C1.-, C3.2, C4.2, C5.2, C6.-, C7.2, C8.2, C10.2, C12.2, C13.2, C14.2, C15.2, C16.2, C17.2, C20.2, C21.2, C23.2, C24.2, C25.2, C26.2, C27.-, C28.2, C29.2, C30.2, C31.2, C32.2, C33.2, C34.2, C35.2, C40.2, C41.2, C42.2, C43.2, C44.-, C45.-, C46.2, IC19.14 (GND), IC19.32 (GND), IC19.50 (GND), IC19.72 (GND), IC19.75 (GND), IC19.82 (GND), IC19.94 (GND), IC19.116 (GND), IC19.134 (GND), IC19.152 (GND), IC19.174 (GND), IC19.180 (GND), IC19.185 (GND), IC19.200 (GND), JP61.2, Q3.1 (E), R20.1, RN4.6, RN5.6, RN7.6, RN8.6, RN9.6, RN10.6, RN11.6, RN12.6, RN13.6, RN14.6, RN15.6, RN16.6, RN21.6, RN22.6, RN23.6, RN24.6, RN25.6, RN26.6, RN27.6, RN28.6, RN29.6, RN30.6, RN31.6, RN32.6; also elsewhere on the board
HK1: RN3.8; also elsewhere on the board
HK2: RN3.9; also elsewhere on the board
HK3: RN3.10; also elsewhere on the board
HK4: RN6.5; also elsewhere on the board
HK5: RN6.6; also elsewhere on the board
HK6: RN6.7; also elsewhere on the board
HK7: RN6.8; also elsewhere on the board
HLT: RN3.7; also elsewhere on the board
HLTM: RN2.9; also elsewhere on the board
IAK_VM: RN2.3; also elsewhere on the board
INIT: RN1.2; also elsewhere on the board
IRQ0: RN3.3; also elsewhere on the board
IRQ1: RN3.4; also elsewhere on the board
IRQ2: RN3.5; also elsewhere on the board
IRQ3: RN3.6; also elsewhere on the board
unnamed: C45.+, D1.2 (A2), JP61.1
unnamed: Q3.2 (B), R19.1, R20.2
RPLY: RN20.5; also elsewhere on the board
RPLY_VM: RN19.3; also elsewhere on the board
SACK: RN19.5; also elsewhere on the board
SEL: RN1.4; also elsewhere on the board
SRAM_CE2: Q3.3 (C), R12.2; also elsewhere on the board
SRAM_CE_G: R19.2; also elsewhere on the board
SSPARE_SEL: RN15.4, RN31.4; also elsewhere on the board
SSYNC: RN19.2; also elsewhere on the board
SYNC: RN6.4; also elsewhere on the board
TA: RN1.5; also elsewhere on the board
UMAP_VM: RN1.6; also elsewhere on the board
WO: RN2.5; also elsewhere on the board
WTBT: RN20.6; also elsewhere on the board
WTBT_VM: RN2.2; also elsewhere on the board

Notes on the sheet:
EXB-F6WT07G
