1801VM3/1801VM3-Board/Eagle/1203_054.brd

## EAGLE design Eagle/1203_054.brd (continued)

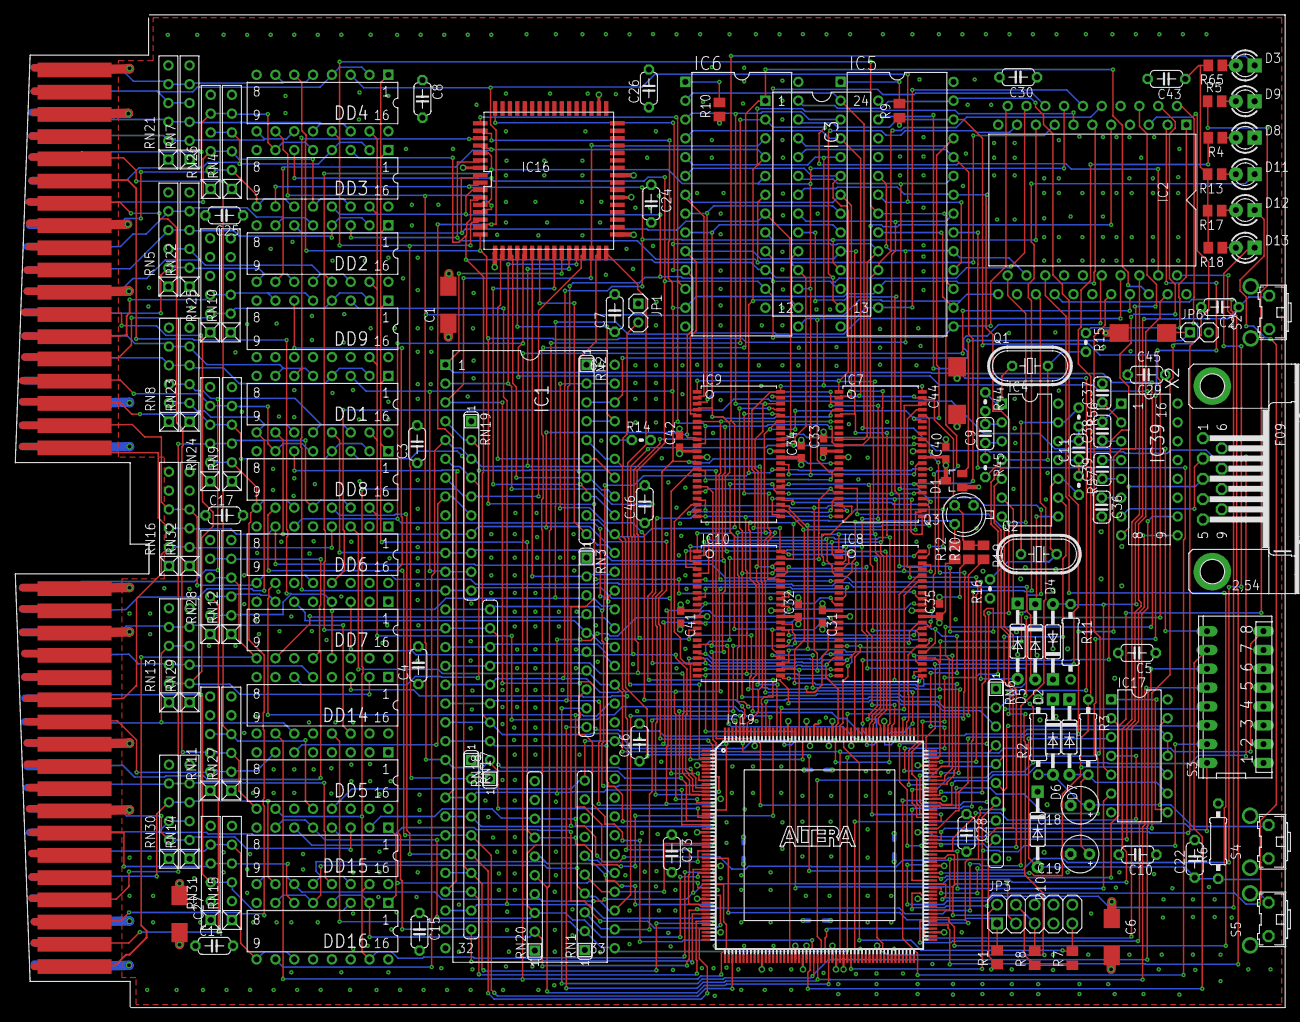
[picture p4: board 1203_054.brd from above]

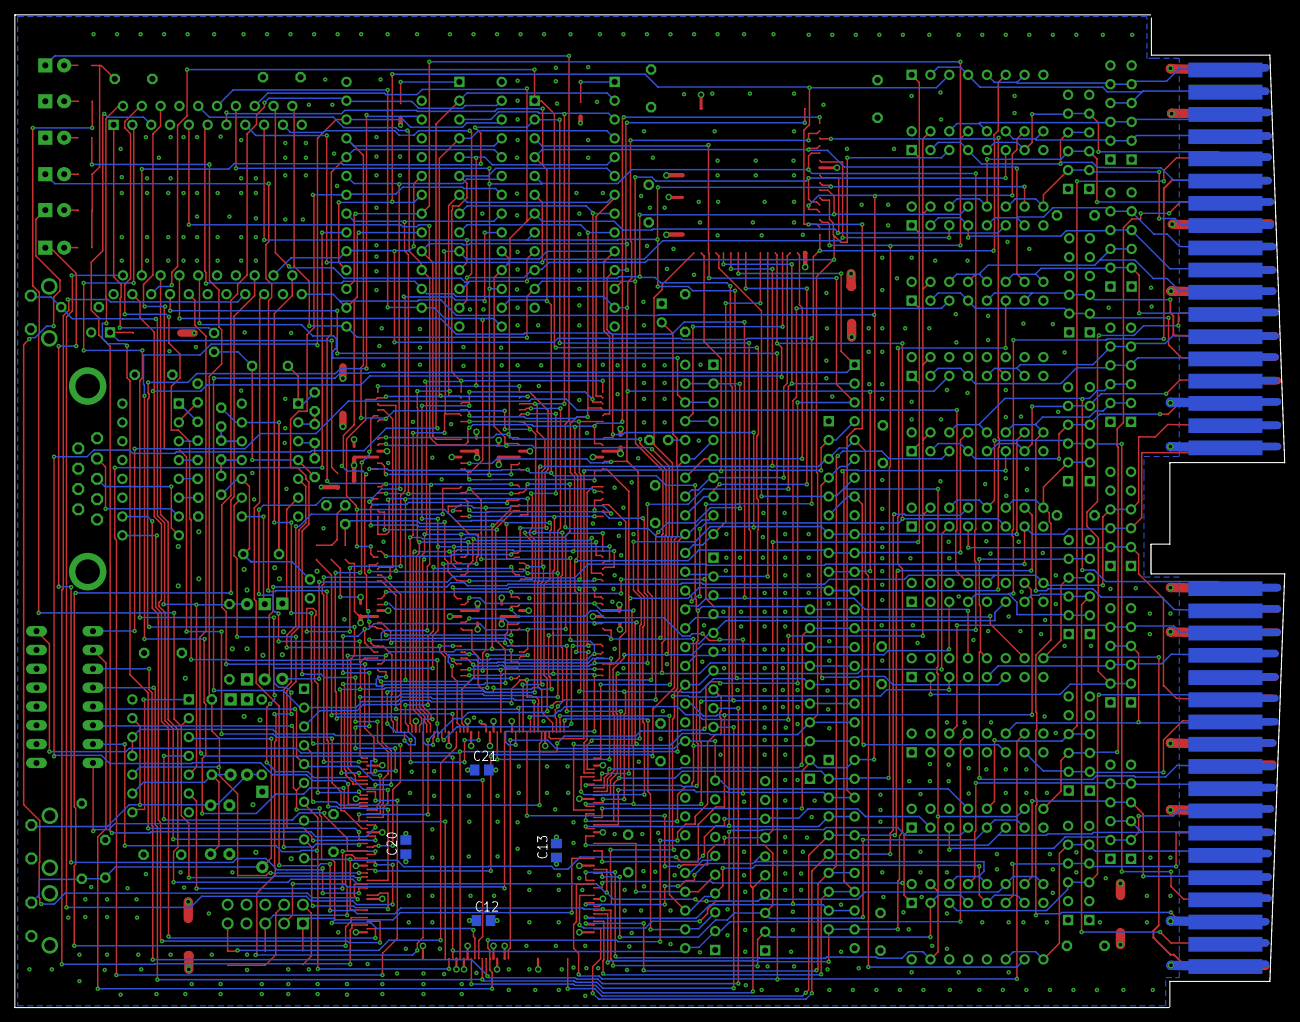
[picture p5: board 1203_054.brd from below]

Board: 3 copper layers, 171.4 x 134.0 mm, 154 parts (4 on the bottom side), 217 nets.
