1801VM3/1801VM3-Board/(commit log)

2017-02-22 try 2
    [1201_2016.smp_dump.txt, 1203_05.brd, 1203_05.sch]
2017-02-23 Eagle files added
    [1203_054.brd, 1203_054.sch]
